ChiragSimepurushkar/CLOUD_MONITORED_ENVIRONMENTAL_ROVER/simulation/3D_model/Screenshoots/Screenshot 2026-05-31 223055.png

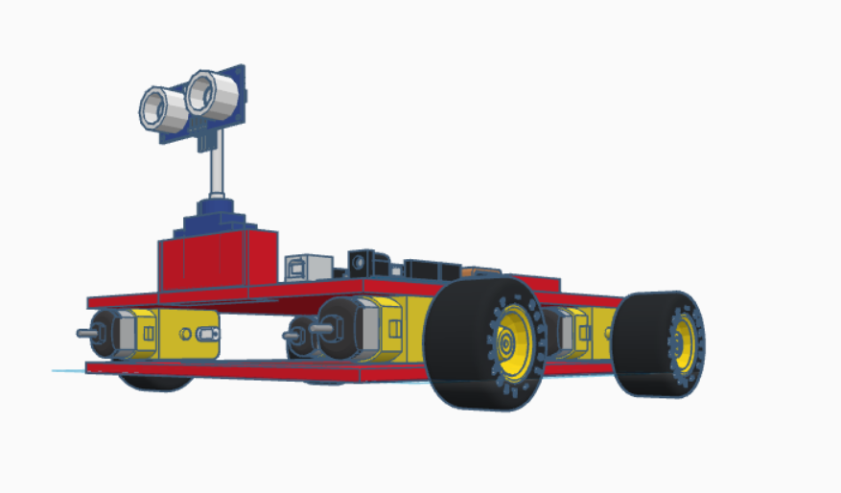
simulation/3D_model/Screenshoots/Screenshot 2026-05-31 223055.png
