ChiragSimepurushkar/CLOUD_MONITORED_ENVIRONMENTAL_ROVER/simulation/circuit/screenshots&video/Screenshot 2026-05-31 222605.png

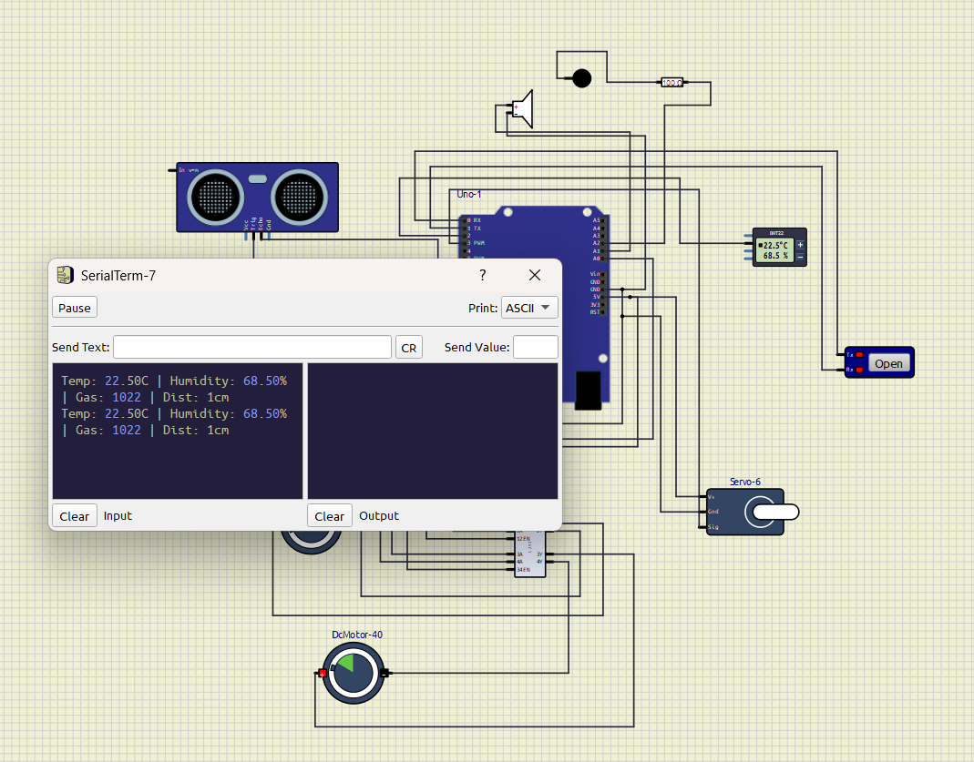
simulation/circuit/screenshots&video/Screenshot 2026-05-31 222605.png
