ChiragSimepurushkar/CLOUD_MONITORED_ENVIRONMENTAL_ROVER/(list of files, drawings)

Other design files:
simulation/circuit/circuit.sim1
