ChiragSimepurushkar/CLOUD_MONITORED_ENVIRONMENTAL_ROVER/(commit log)

2026-06-01 feat: Combined Dashboard v3.0 — 3D Digital Twin + Advanced Sensor Dashboard
    WHAT'S IN THIS BRANCH:
    - Unified backend (server.js) serving /rover-data (3D), /sensor-data (legacy),
    /simulate, /chart-data, /map-state, /alerts, /health endpoints
    - Single shared Socket.io server emitting map-update, raw-data, chart-update,
    chart-init, newAlert — feeds both 3D map and live charts simultaneously
    - Premium glassmorphism design system (index.css) with JetBrains Mono + Inter fonts
    PAGES:
    Dashboard — Live area charts (recharts), gauge bars, stat cards, packet table
    3D Live Map — Full React Three Fiber map: grid cells, rover cone, path trail,
    scan ring, camera follow, au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
2026-06-01 feat(simulation): add 3D rover chassis models and circuit simulations
    [circuit.sim1]
2026-06-01 fix: History page (Legend import), ESLint warnings, rover 3D model (red chassis + 4 wheels + sonar)
2026-06-02 fix: Dashboard/History scroll bug + chart sizing
    ROOT CAUSE: Triple overflow:hidden (html/body/#root + div + main) blocked all page scrolling.
    FIX: Changed main overflow from hidden to auto.
    Chart fixes:
    - Dashboard: area chart 100%/flex -> explicit 340px, removed minHeight:0 grid collapse
    - History: temperature 180->280px, humidity+gas 180->280px, gas bar 130->220px
    - History data table: maxHeight 220->360px
    Pages now scroll properly and charts are properly sized for viewing.
2026-06-02 feat: Real room scanning system — Phase 2-5 complete
    BACKEND (Phase 2-3):
    + backend/gridMap.js [NEW]: Bresenham occupancy grid engine
    - 25cm x 25cm cells, probabilistic FREE/WALL/SUSPECT/UNKNOWN types
    - processPacket(): works with scan[] (13-ray sweep) AND legacy single-point
    - Bresenham ray tracing: cells along ray = FREE, endpoint = WALL
    - Wall confirmed after 3+ hits, confidence grows with hits
    - Sensor overlay per cell: avgTemp, avgGas, avgHum
    - getScanHistory() for replay mode
    - reset() clears everything
    backend/server.js [v4.0]: Integrates gridMap.js
    - /rover-data: auto-detects scan[] vs legacy, routes to gridEngine
    - /simulate: sends fake 13-ray scan for browser t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
2026-06-02 fix: ESLint warnings + simulate/replay working + OFFLINE status bug
    ESLint fixes (Map3D.js):
    - Remove unused Text, PerspectiveCamera imports
    - Remove unused targetPos, targetRot refs in RoverModel
    - Remove unused latestScan, d, cellCount variables
    ESLint fixes (Dashboard.js):
    - Remove unused S (sans-serif) constant
    OFFLINE status bug fix (Map3D.js):
    - useState(socket.connected) instead of useState(false)
    - So if socket already connected before Map3D mounts, shows LIVE correctly
    Simulate fix:
    - Removed unused response variable (d)
    - Rays still flash from client immediately on fetch resolve
    Socket map-update now includes lastScan array (server.js):
    - /rover-data: lastScan = d.scan (when us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
2026-06-02 fix: zero warnings — craco webpack config + flashRays hook order
    Map3D.js:
    - Moved flashRays useCallback BEFORE the useEffect that uses it
    - Added [flashRays] to useEffect dependency array
    - Fixes: react-hooks/exhaustive-deps warning (Line 423)
    package.json:
    - Switched start/build/test scripts from react-scripts to craco
    - craco intercepts webpack config without ejecting CRA
    craco.config.js [NEW]:
    - Excludes node_modules from source-map-loader processing
    - Permanently silences @mediapipe/tasks-vision .map file warning
    - No more 'Failed to parse source map' on every compile
2026-06-02 fix: simulate & connection via socket.io — no more BadRequestError
    Root cause: browser's HTTP/1.1 connection pool conflicts with existing
    socket.io WebSocket when doing fetch() POST to same server on port 5000.
    The TCP connection gets reused from a stale pool entry and aborted mid-body.
    server.js:
    - buildSimPacket() helper extracted (shared by HTTP + socket handler)
    - io.on('connection') now handles 'client-simulate' event via WebSocket
    - io.on('connection') now handles 'client-reset' event via WebSocket
    - /rover-data: added req.on('close') abort guard + try-catch
    - /simulate: wrapped in try-catch (HTTP fallback still works)
    - Removed debug console.log left in /rover-data
    - doS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
2026-06-02 fix: synthetic event payload causing socket.io stack overflow & NaN temps
    Root cause: the onClick={doSimulate} binding was passing the React
    SyntheticEvent object directly into the customData argument of doSimulate.
    Since this event has massive circular references (DOM nodes, etc.),
    socket.emit('client-simulate', body) triggered an infinite recursion in
    socket.io-client's hasBinary() parser, crashing the app.
    Fix:
    - Changed onClick={doSimulate} to onClick={() => doSimulate()}
    - Added an extra safety guard in doSimulate to ignore event objects
    - Handled Infinity/null parsing correctly for min/max temperature displays
    so they now gracefully show '--' instead of 'undefined°C' or NaN.
2026-06-02 fix: silently catch Arduino request.aborted errors
    Root cause: The Arduino ESP8266 frequently sends its POST request
    and immediately closes the TCP connection (AT+CIPCLOSE) before Node
    has completely parsed the incoming JSON body. This caused express.json()
    to throw 'BadRequestError: request aborted', which by default prints
    a giant stack trace to the console on every packet.
    Fix: Added a global Express error-handling middleware to intercept
    'request.aborted' errors specifically and silently return a 400
    without polluting the console.
2026-06-02 fix: reduce Arduino scan packet size to 7 angles & add transmission delays for stability
2026-06-02 fix: LIVE/OFFLINE status + instant data display on all pages
    Problem 1: Sidebar and Dashboard showed DISCONNECTED even when Arduino
    data was flowing. Root cause: socket.io's 'connect' event fires before
    React mounts, so the event handler is never triggered. Fix: set initial
    state from socket.connected AND poll every 1 second.
    Problem 2: Dashboard showed no data until next Arduino packet arrived
    (up to 25 seconds). Fix: already fetches /chart-data on mount and
    listens for chart-init — verified working.
    Problem 3: Server logs didn't show temp/humidity, making it impossible
    to debug whether Arduino was actually sending sensor data. Fix: added
    T= and H= fields to the console log line.
    Files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
2026-06-03 fix: LIVE status tracks rover data + restore detailed 3D rover model
    LIVE/OFFLINE REWORK:
    - 'ROVER LIVE' now means the rover sent data in the last 30 seconds
    - 'NO DATA' means no rover packets have arrived (or stale >30s)
    - Sidebar shows separate 'WS checkmark/x' badge for WebSocket state
    - Applied consistently across App.js sidebar, Dashboard, and Map3D header
    - Previously: showed LIVE even when rover was disconnected, because it
    only tracked WebSocket state (which is always true when server runs)
    3D ROVER MODEL:
    - Restored the detailed rover model from commit 06e5014 (the 'good' one)
    - Red chassis with proper proportions (0.30 x 0.04 x 0.22)
    - 4 wheels with black tyre + yellow rim + met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
2026-06-03 CRITICAL FIX: socket.io emits were blocked by Arduino TCP abort
    ROOT CAUSE FOUND:
    The Arduino ESP8266 sends POST /rover-data then immediately calls
    AT+CIPCLOSE, closing the TCP socket. Node.js fires req.on('close')
    which sets aborted=true BEFORE the io.emit() calls execute.
    The old code had ALL three socket.io emits (raw-data, map-update,
    chart-update) inside 'if (!aborted)', so when the Arduino hung up
    early (which is EVERY packet), the browser NEVER received any data.
    The data was being processed and stored in gridEngine and chartBuffer,
    but never broadcast to the browser WebSocket. This is why:
    - The server log showed data arriving correctly
    - The webpage showed NO DATA with 0 packets
    -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
2026-06-03 fix: deep-clone ALL socket.io data + green origin marker + suppress warning
    SOCKET.IO DATA FIX (server.js):
    - Deep-clone ALL emitted data with JSON.parse(JSON.stringify()) in:
    (1) /rover-data route handler
    (2) socket connection handler (initial state on connect)
    (3) client-simulate handler
    - Root cause: socket.io was silently failing to serialize data because
    gridEngine.getState() returns direct references to mutable module-level
    objects (occupancyGrid, sensorGrid). These references can be mutated
    between the io.emit() call and when socket.io actually serializes them.
    - Made /rover-data handler fully synchronous (no async/await). All async
    operations (checkAlert, DB write) are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
2026-06-03 fix: map coverage — increase sonar range + add scan ring + lighting
    GRID ENGINE (gridMap.js):
    - MAX_DIST: 180 → 400cm (HC-SR04 actual range is ~400cm)
    Previously, ANY sonar reading > 180cm was silently discarded. This
    meant walls 2-4 meters away were invisible. Now all valid readings
    up to 4m are processed, creating far more floor + wall cells.
    - WALL_MIN_HITS: 3 → 2 (faster wall confirmation)
    With the rover moving slowly, needing 3 separate ray hits on the
    same 25cm cell was too strict. 2 hits is sufficient for confirmation.
    - OCC_BOOST: 0.18 → 0.22 (walls confirm faster)
    - Added scan ray distance logging: each packet now prints individual
    ray distances so we can see exa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
2026-06-05 feat: floating sensor labels on 3D tiles + ALL combined view mode
    SENSOR LABELS (Map3D.js):
    - Each floor tile now shows a floating glass-panel label above it
    when a sensor view mode is active (gas/temp/humidity/all)
    - Labels use drei's Html component for crisp CSS-based rendering
    - Labels auto-scale with camera distance (distanceFactor=6)
    - Individual modes show: header (GAS/TEMP/HUM) + value + unit
    - Values are color-coded to match the tile color (green/orange/red)
    - Glass-panel style: dark bg, blur, cyan border, subtle glow
    ALL VIEW MODE:
    - New 5th button in the header bar: 'ALL'
    - Shows all 3 sensor readings stacked vertically on each tile:
    Thermometer emoji + temp, Droplet emoji + h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
2026-06-05 feat: full light/dark theme toggle across all pages
    THEME SYSTEM (index.css):
    - Added [data-theme='light'] CSS variable overrides for ALL tokens
    - Light theme: soft warm whites/grays, white cards with shadows,
    darkened cyan accent (#0099cc) for contrast on white backgrounds,
    dark text grays, soft rgba(0,0,0,0.08) borders
    - Scan-line overlay hidden in light mode (cosmetically wrong on white)
    - Scrollbar turns gray in light mode
    - Smooth 0.3s transitions on ALL elements for seamless toggle
    - .theme-toggle utility class for styled toggle button
    THEME CONTEXT (App.js):
    - Added ThemeContext + useTheme() hook exported for all pages
    - Theme stored in localStorage (persists across refresh)
    - Ap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
2026-06-05 fix: minimap stays dark in dark mode
    Root cause: bgColor and isDark were NOT in the useEffect dependency
    array, so the minimap canvas never redrawn when toggling themes.
    Fixes:
    - Added [bgColor, isDark] to Minimap2D useEffect deps
    - Canvas redraws immediately on every theme switch
    - Dark mode: walls #3a7ab4, free tiles dim cyan, rover dot #00d4ff
    - Light mode: walls #2d5fa0, free tiles slate blue, rover dot #0077cc
    - 'No data' text color also adapts per theme
2026-06-07 feat: MIT App Inventor full integration - auto/manual mode switching
2026-06-07 feat: v4.5 - merge poll into upload POST, fix ESP closed early error
    [rover_arduino.ino]
2026-06-07 fix: move Express error handler after routes, fix aborted socket handler
2026-06-07 chore: add explicit payload logging to debug Arduino POST truncation
2026-06-07 fix: resolve Arduino OOM string concatenation bug causing TCP truncation
    [rover_arduino.ino]
2026-06-07 docs: comprehensive README with full architecture, wiring, API, algorithm, and dev journey
2026-06-08 finalize 3D rover model and Proteus circuit simulation
    [circuit.sim1]
2026-08-01 feat: update server.js v4.6 manual hold timer + comprehensive README
2026-08-01 chore: polish repo — comprehensive .gitignore, remove hardcoded WiFi creds, update README file tree with simulation/
